MarcosAsh/protocol-emulator-bench/carrier/renders/B_Cu.png

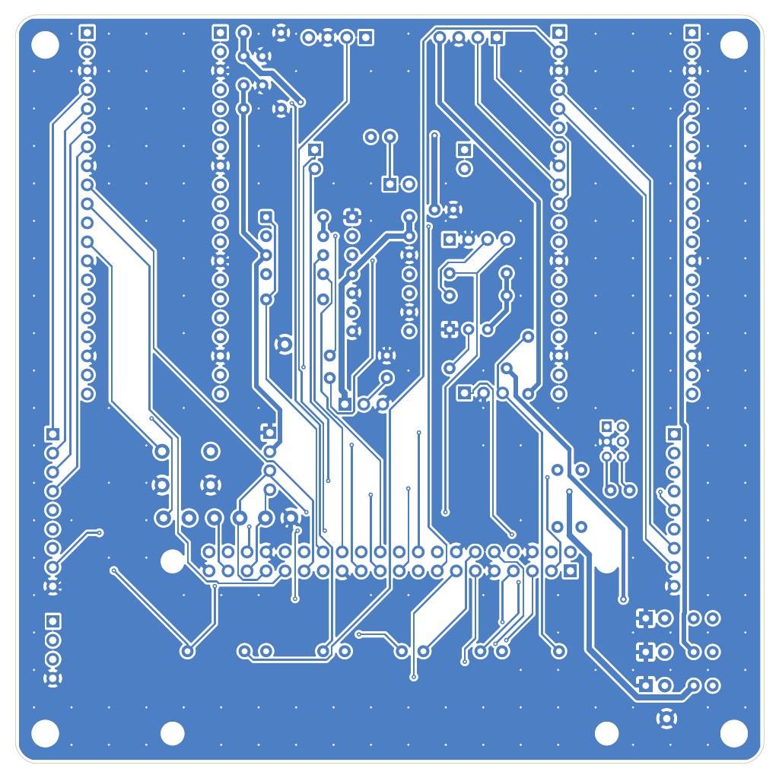
carrier/renders/B_Cu.png
