MarcosAsh/protocol-emulator-bench/carrier/renders/B_Silk.png

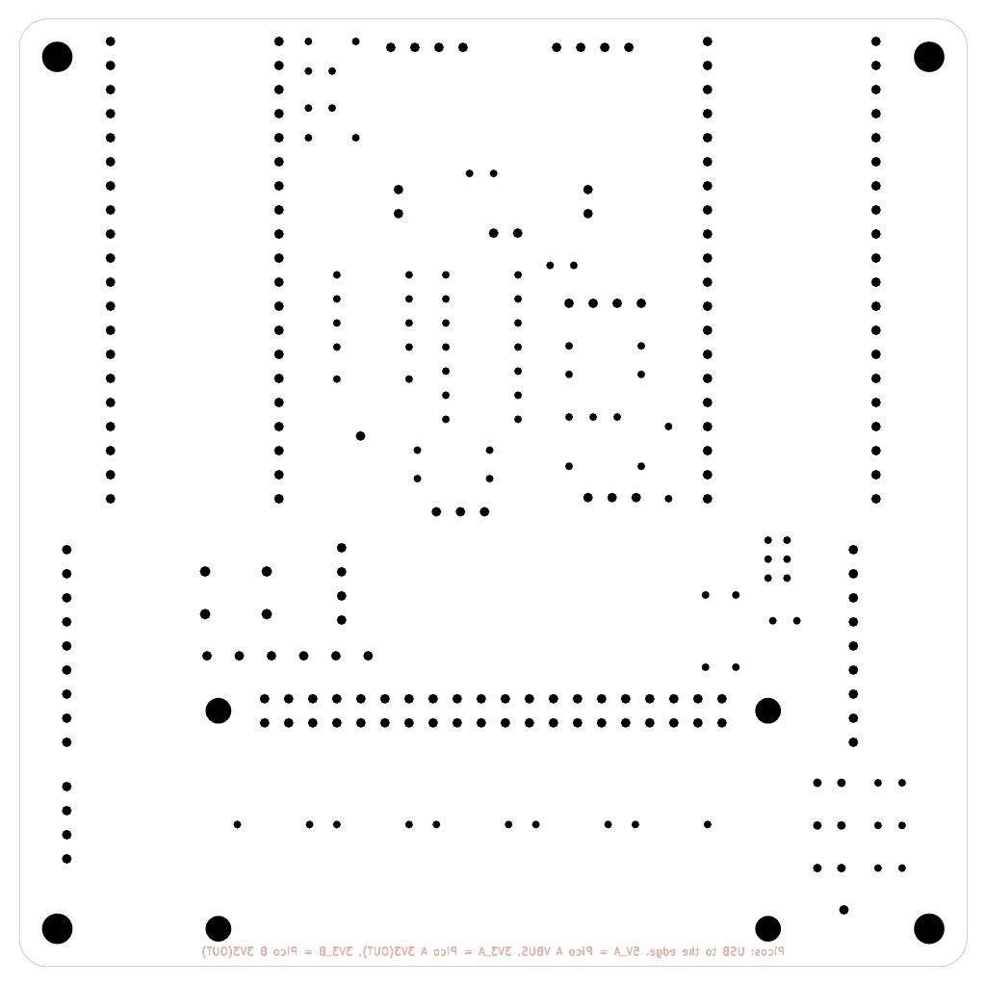
carrier/renders/B_Silk.png
