MarcosAsh/protocol-emulator-bench/carrier/renders/F_Cu.png

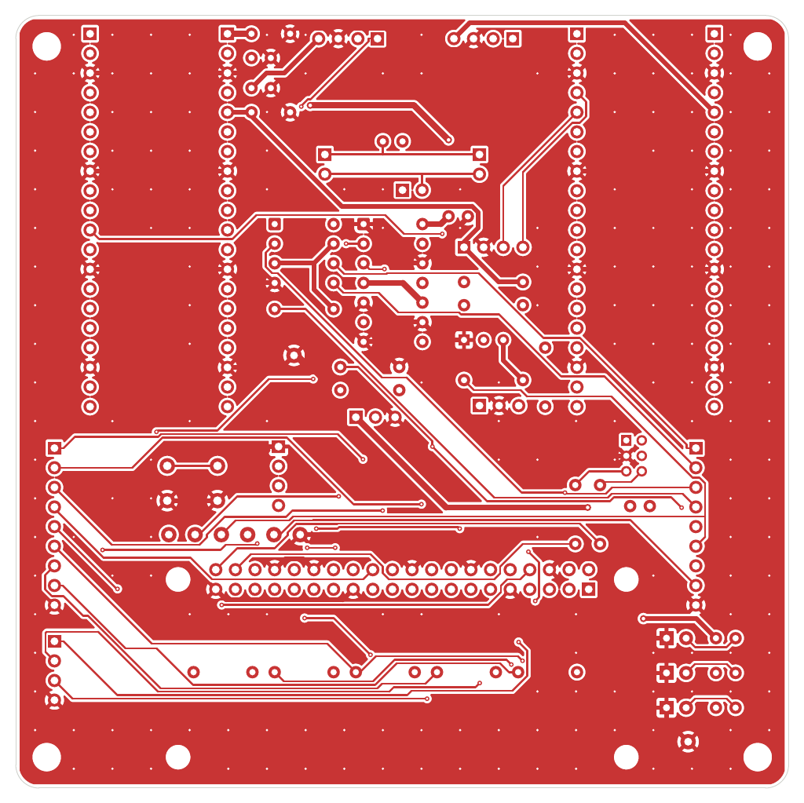
carrier/renders/F_Cu.png
