MarcosAsh/protocol-emulator-bench/carrier/renders/F_Silk.png

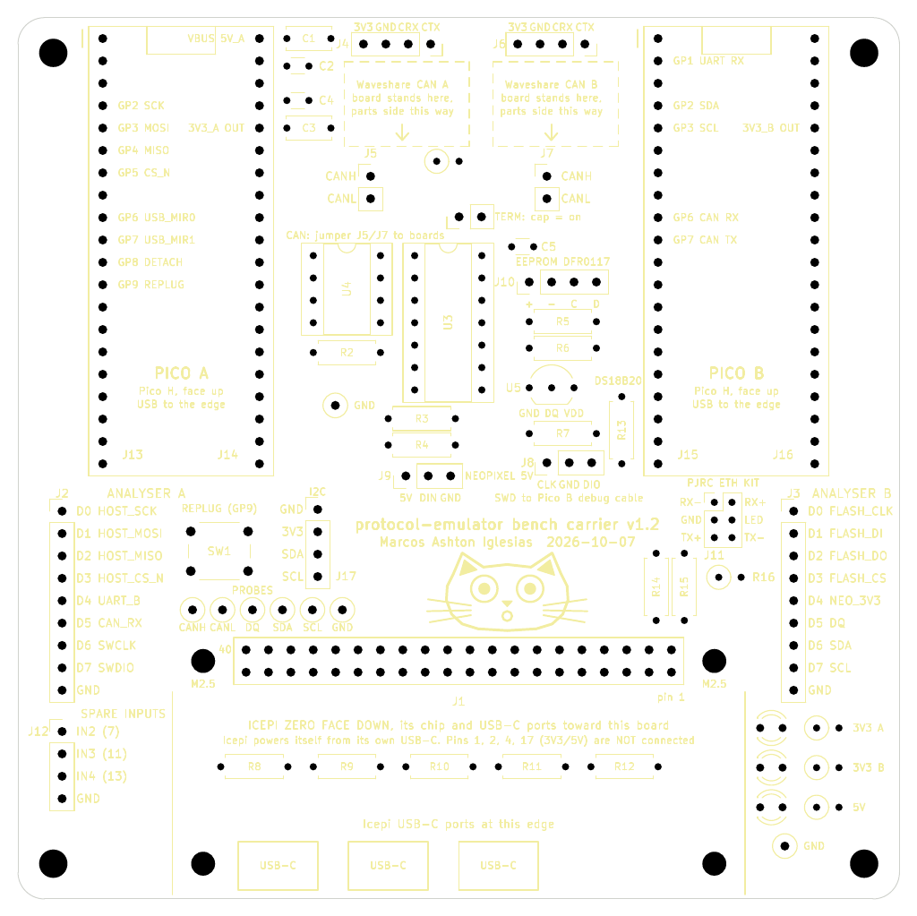
carrier/renders/F_Silk.png
