MarcosAsh/protocol-emulator-bench/carrier/renders/Fab.png

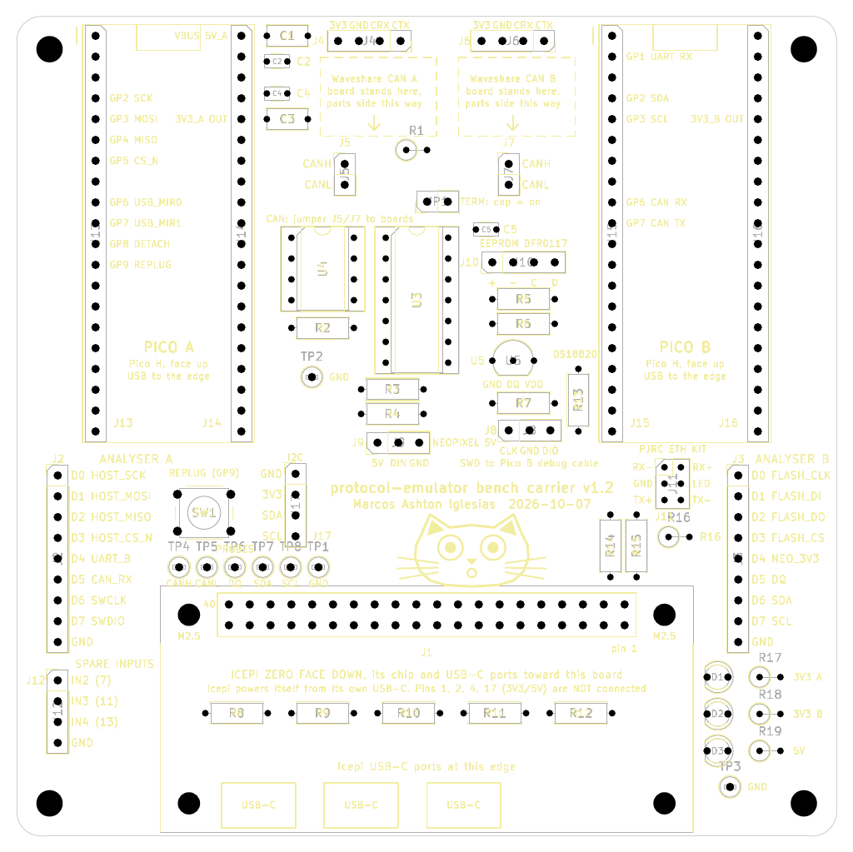
carrier/renders/Fab.png
