MarcosAsh/protocol-emulator-bench/carrier/renders/render_bottom.png

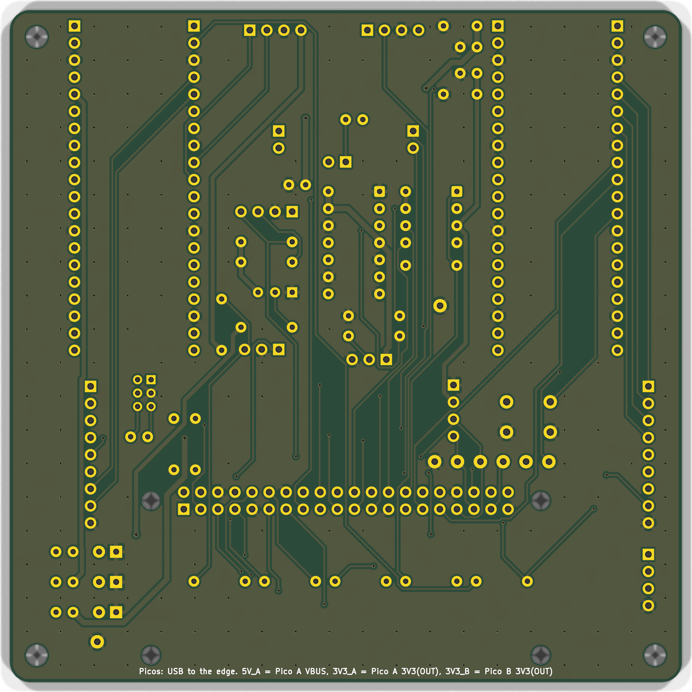
carrier/renders/render_bottom.png
