MarcosAsh/protocol-emulator-bench/carrier/carrier.kicad_pcb

## KiCad design carrier/carrier.kicad_pcb (2026-10-15)

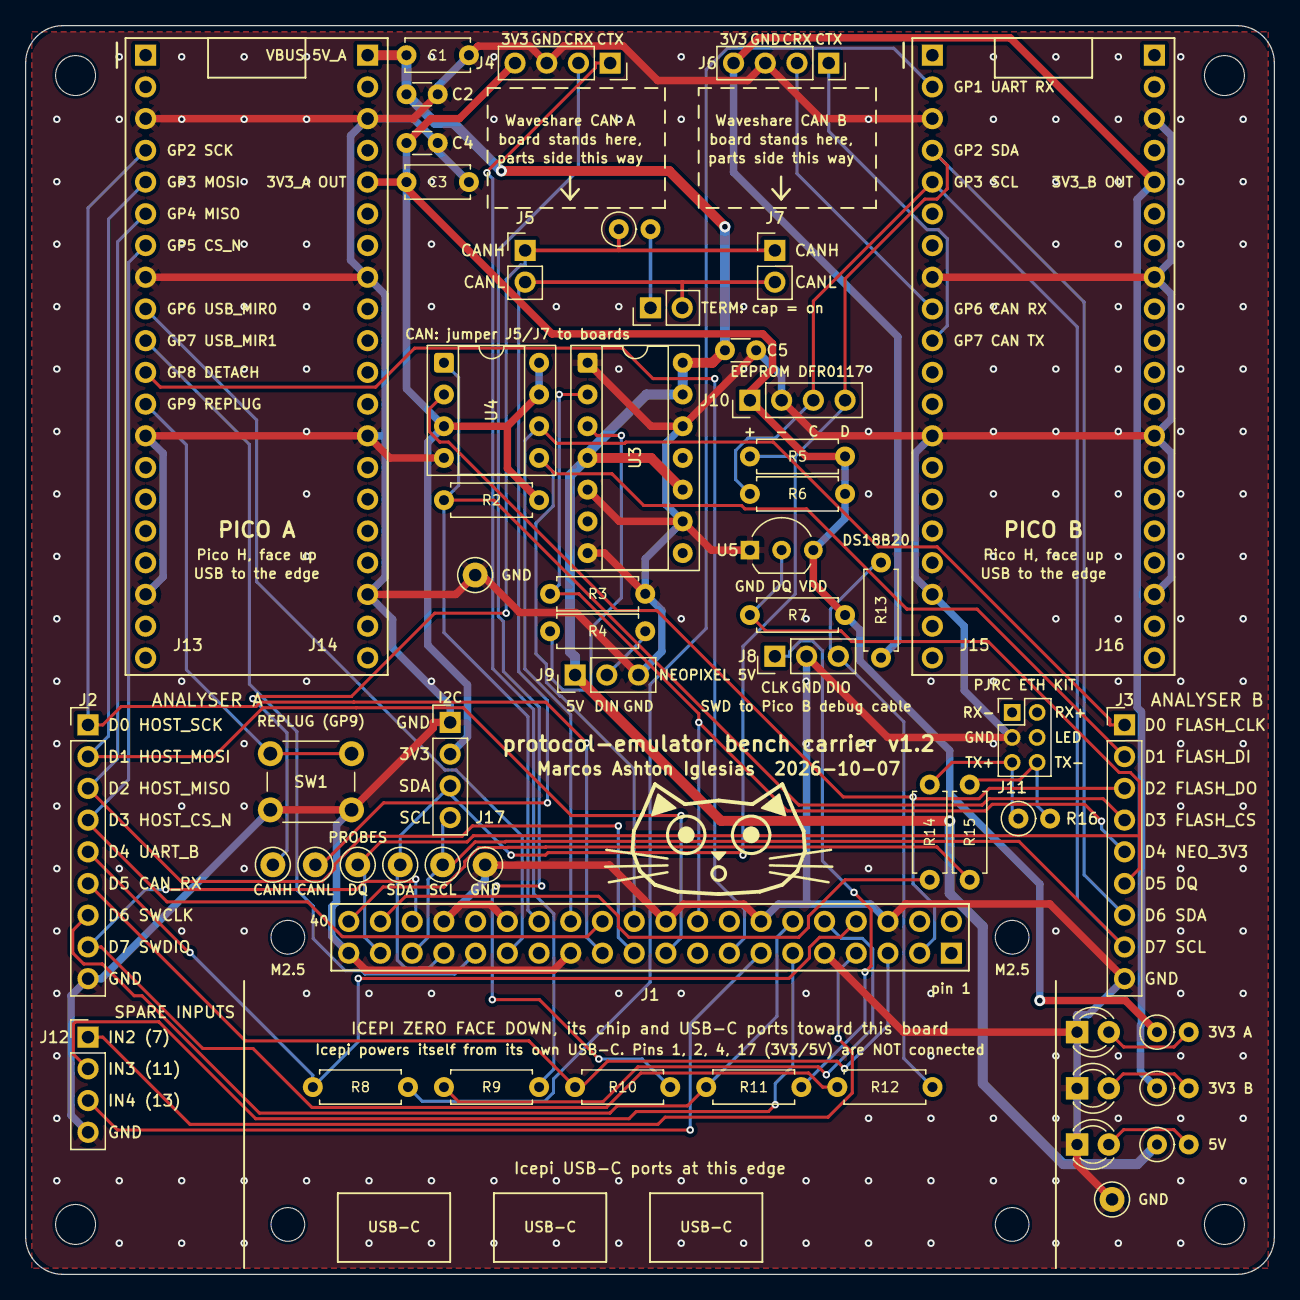
[picture p8: board carrier.kicad_pcb from above]

Board: 2 copper layers, 100.0 x 100.0 mm, 65 parts (0 on the bottom side), 47 nets.

Parts:
C1, C3: 10u; C_Disc_D5.0mm_W2.5mm_P5.00mm
C2, C4, C5: 100n; C_Disc_D3.0mm_W1.6mm_P2.50mm
D1, D2: green; LED_D3.0mm
D3: red; LED_D3.0mm
H1, H2, H3, H4: M3; MountingHole_3.2mm_M3
H5, H6, H7, H8: M2.5; MountingHole_2.7mm_M2.5
J1: Icepi Zero; IcepiZero_Socket_2x20_FaceDown
J2: ANALYSER A; PinHeader_1x09_P2.54mm_Vertical
J3: ANALYSER B; PinHeader_1x09_P2.54mm_Vertical
J4: CAN A; PinSocket_1x04_P2.54mm_Vertical
J5: CAN A BUS; PinHeader_1x02_P2.54mm_Vertical
J6: CAN B; PinSocket_1x04_P2.54mm_Vertical
J7: CAN B BUS; PinHeader_1x02_P2.54mm_Vertical
J8: SWD; PinHeader_1x03_P2.54mm_Vertical
J9: NEOPIXEL; PinHeader_1x03_P2.54mm_Vertical
J10: EEPROM; PinHeader_1x04_P2.54mm_Vertical
J11: ETHERNET; PinHeader_2x03_P2.00mm_Vertical
J12: SPARE; PinHeader_1x04_P2.54mm_Vertical
J13: Pico A left; PinSocket_1x20_P2.54mm_Vertical_NoSilk
J14: Pico A right; PinSocket_1x20_P2.54mm_Vertical_NoSilk
J15: Pico B left; PinSocket_1x20_P2.54mm_Vertical_NoSilk
J16: Pico B right; PinSocket_1x20_P2.54mm_Vertical_NoSilk
J17: I2C; PinHeader_1x04_P2.54mm_Vertical
JP1: TERM; PinHeader_1x02_P2.54mm_Vertical
R1: 120R; R_Axial_DIN0207_L6.3mm_D2.5mm_P2.54mm_Vertical
R2, R3: 10k; R_Axial_DIN0207_L6.3mm_D2.5mm_P7.62mm_Horizontal
R4: 330R; R_Axial_DIN0207_L6.3mm_D2.5mm_P7.62mm_Horizontal
R5, R6: 2k2; R_Axial_DIN0207_L6.3mm_D2.5mm_P7.62mm_Horizontal
R7, R13: 4k7; R_Axial_DIN0207_L6.3mm_D2.5mm_P7.62mm_Horizontal
R8, R9, R10: 1k; R_Axial_DIN0207_L6.3mm_D2.5mm_P7.62mm_Horizontal
R11, R12: 220R; R_Axial_DIN0207_L6.3mm_D2.5mm_P7.62mm_Horizontal
R14, R15: 47R; R_Axial_DIN0207_L6.3mm_D2.5mm_P7.62mm_Horizontal
R16: 470R; R_Axial_DIN0207_L6.3mm_D2.5mm_P2.54mm_Vertical
R17, R18, R19: 1k; R_Axial_DIN0207_L6.3mm_D2.5mm_P2.54mm_Vertical
SW1: REPLUG; SW_PUSH_6mm
TP1, TP2, TP3: GND; TestPoint_Keystone_5000-5004_Miniature
TP4: CANH; TestPoint_Keystone_5000-5004_Miniature
TP5: CANL; TestPoint_Keystone_5000-5004_Miniature
TP6: DQ; TestPoint_Keystone_5000-5004_Miniature
TP7: SDA; TestPoint_Keystone_5000-5004_Miniature
TP8: SCL; TestPoint_Keystone_5000-5004_Miniature
U3: 74AHCT125; DIP-14_W7.62mm_Socket
U4: W25Q64 breakout; DIP-8_W7.62mm_Socket
U5: DS18B20; TO-92_Inline_Wide

Connections:
3V3_A: C3.1, C4.1, J4.4, J10.1, J14.5, J17.2, R2.2, R5.2, R6.2, R7.2, R17.1, U4.3, U4.7, U4.8, U5.3
3V3_B: J6.4, J16.5, R13.2, R18.1
5V_A: C1.1, C2.1, C5.1, J9.1, J14.1, R19.1, U3.4, U3.10, U3.13, U3.14
CANA_CRX: J4.2, R10.2
CANA_CTX: J4.1, R9.2
CANB_RX: J6.2, J15.9
CANB_TX: J6.1, J15.10
CANH: J5.1, J7.1, R1.1, TP4.1
CANL: J5.2, J7.2, JP1.2, TP5.1
CAN_RX: J1.5, J2.6, R10.1
CAN_TERM: JP1.1, R1.2
CAN_TX: J1.10, R9.1
DQ: J1.37, J3.6, R7.1, TP6.1, U5.2
ETH_TXN: J1.40, R15.1
ETH_TXN_J: J11.6, R15.2, R16.2
ETH_TXP: J1.38, R14.1
ETH_TXP_J: J11.5, R14.2, R16.1
FLASH_CLK: J1.26, J3.1, U4.6
FLASH_CS_N: J1.28, J3.4, R2.1, U4.1
FLASH_DI: J1.22, J3.2, U4.5
FLASH_DO: J1.3, J3.3, U4.2
GND: C1.2, C2.2, C3.2, C4.2, C5.2, D1.1, D2.1, D3.1, J1.6, J1.9, J1.14, J1.20, J1.25, J1.30, J1.34, J1.39, J2.9, J3.9, J4.3, J6.3, J8.2, J9.3, J10.2, J11.3, J12.4, J13.3, J13.8, J13.13, J13.18, J14.3, J14.8, J14.13, J14.18, J15.3, J15.8, J15.13, J15.18, J16.3, J16.8, J16.13, J16.18, J17.1, R3.2, SW1.2, TP1.1, TP2.1, TP3.1, U3.1, U3.5, U3.7, U3.9, U3.12, U4.4, U5.1
HOST_CS_N: J1.24, J2.4, J13.7
HOST_MISO: J1.21, J2.3, J13.6
HOST_MOSI: J1.19, J2.2, J13.5
HOST_SCK: J1.23, J2.1, J13.4
I2C_SCL: J1.35, J3.8, J10.3, J15.5, J17.4, R6.1, TP8.1
I2C_SDA: J1.33, J3.7, J10.4, J15.4, J17.3, R5.1, TP7.1
LED_3V3A: D1.2, R17.2
LED_3V3B: D2.2, R18.2
LED_5V: D3.2, R19.2
NEO_3V3: J1.18, J3.5, R3.1, U3.2
NEO_5V: R4.1, U3.3
NEO_DIN: J9.2, R4.2
REPLUG: J13.12, SW1.1
SPARE_IN2: J1.7, J12.1
SPARE_IN3: J1.11, J12.2
SPARE_IN4: J1.13, J12.3
SWCLK: J1.12, J2.7, R11.1
SWCLK_PICO: J8.1, R11.2
SWDIO: J1.36, J2.8, R12.1
SWDIO_PICO: J8.3, R12.2, R13.1
UART_B: J1.8, J2.5, R8.1
UART_B_PICO: J15.2, R8.2
USB_DETACH: J1.15, J13.11
USB_MIR0: J1.29, J13.9
USB_MIR1: J1.31, J13.10
