MarcosAsh/protocol-emulator-bench/(commit log)

2026-10-15 add the carrier board v1.2 and the script that generates it
    [bom.csv, carrier.kicad_pcb, netlist.csv]
2026-10-15 add the gerbers and jlc assembly files the boards were ordered with
    [carrier-B_Cu.gbl, carrier-B_Mask.gbs, carrier-B_Paste.gbp, carrier-B_Silkscreen.gbo, carrier-Edge_Cuts.gm1, carrier-F_Cu.gtl, carrier-F_Mask.gts, carrier-F_Paste.gtp]
2026-10-15 add renders of the board and each layer
